Ankermgmt/ankermake-m5-muffler/README.md

# AnkerMake M5 Muffler

## Firmware

For instructions on installing firmware, see the [firmware README](firmware/README.md).

## Hardware

All files required to build the hardware are in the [hardware](hardware) directory. See the [hardware README](hardware/README.md) for more information.
