Ankermgmt/ankermake-m5-muffler/hardware/v0.7/PCB v15.pdf

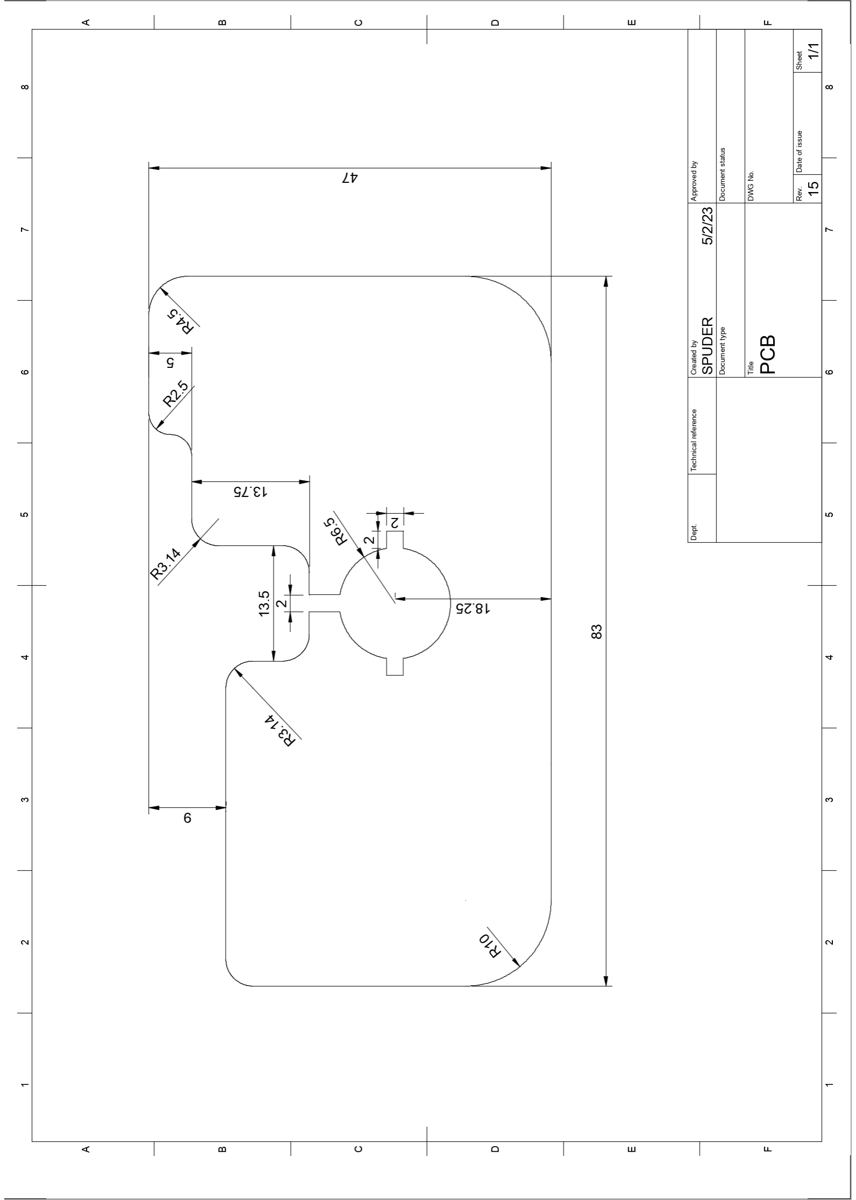
[picture p1: page 1]
