Ankermgmt/ankermake-m5-muffler/hardware/v0.6/pcb_dimensions.pdf

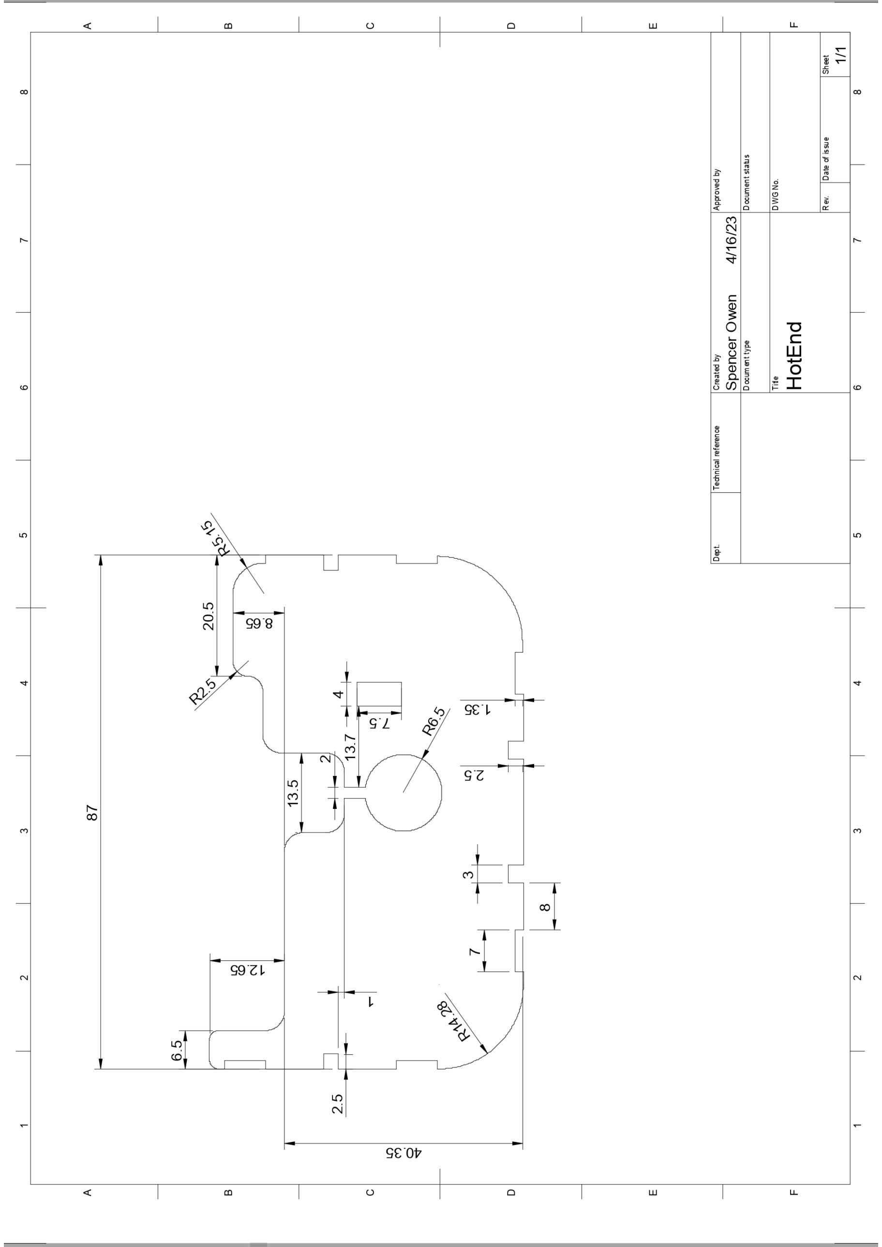
[picture p2: page 1]
