Ankermgmt/ankermake-m5-muffler/images/muffler3.png

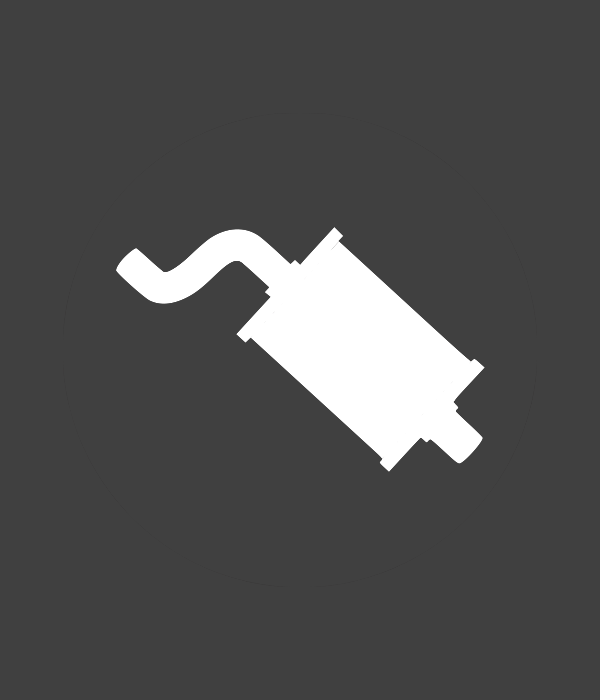
images/muffler3.png
