Ankermgmt/ankermake-m5-muffler/images/ship.png

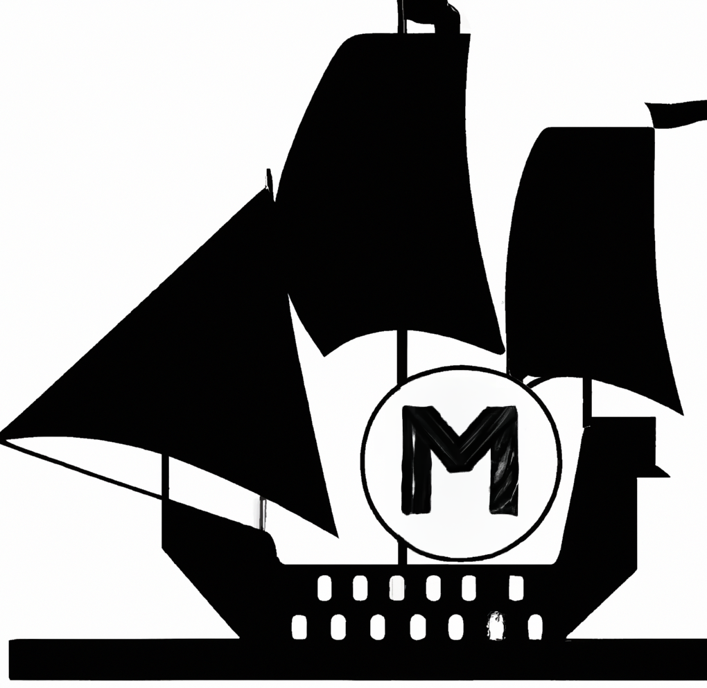
images/ship.png
