Ankermgmt/ankermake-m5-muffler/hardware/v0.7/BOM_PCB.csv

ID | Name | Designator | Footprint | Quantity | Manufacturer Part | Manufacturer | Supplier | Supplier Part | Price
1 | SK6812-SIDE-4020 | U10,U11,U12,U13,U14,U15,U16,U17,U18,U19,U20,U21,U22,U23 | SK6812-SIDE-4020 PNP | 14 | SK6812SIDE-A-RVS | 欧思科光电 | LCSC | C2890037 | 0.03
2 | 5K1 | R2,R3 | R0805 | 2 | PTFR0805B5K10N9 | RESI(开步睿思） | LCSC | C328447 | 0.026
3 | Temp | CN1 | CONN-SMD_XH-2PWBPZ | 1 | XH-2PWBPZ | BOOMELE(博穆精密) | LCSC | C2687444 | 0.012
4 | 300 | R8 | R0805 | 1 | PTFR0805B300KP9 | RESI(开步睿思） | LCSC | C2849164 | 0.023
5 | 220n | C3,C4 | C0805 | 2 | C2012X8R1E224K125AA | TDK | LCSC | C2172799 | 0.009
6 | 470u | C2 | CAP-D4.0×H5.5 | 1 |  | KNSCHA(科尼盛)
7 | BSS138W | Q1 | SOT-323-3_L2.0-W1.3-P1.30-LS2.1-BR | 1 | BSS138W-TP-ES | ElecSuper(静芯微） | LCSC | C5224284 | 0.003
8 | 10k | R5,R6 | R0805 | 2 | PTFR0805B10K0P9 | RESI(开步睿思） | LCSC | C478887 | 0.023
9 | PC817(SMD) | U4 | SMD-4_L4.6-W6.5-P2.54-LS10.2-TL-A | 1 | PC817X4CSP9F | SHARP(夏普) | LCSC | C500391 | 0.018
10 | 10u | C1 | C0805 | 1 | GRM188R71H104KA93D | muRata(村田) | LCSC | C77055 | 0.001
11 | NTR4501N | Q1-B | SOT-23-3_L2.9-W1.3-P1.90-LS2.4-BR | 1 | NTR4501NT1G | onsemi(安森美) | LCSC | C85416 | 0.034
12 | 100k | R1 | R0805 | 1 | PTFR0805B100KN9 | RESI(开步睿思） | LCSC | C328434 | 0.027
