Ankermgmt/ankermake-m5-muffler/hardware/v0.7/PCB v15.step

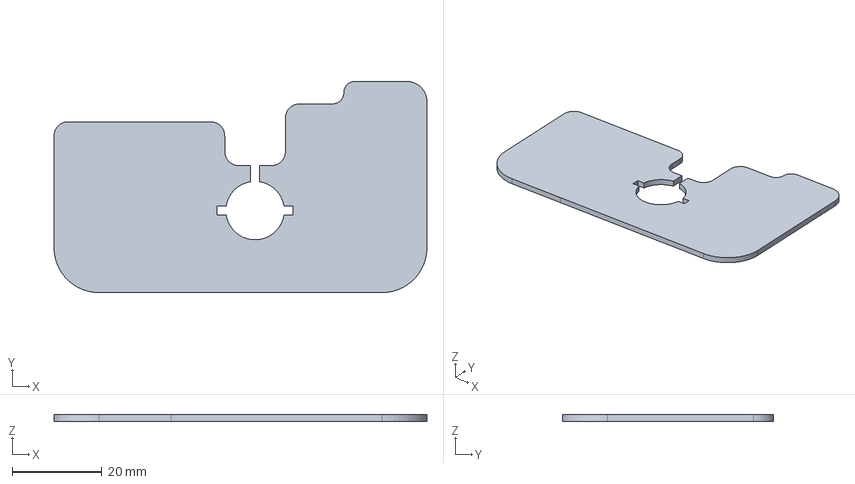
[picture p5: CAD file, 2023-04-30]
hardware/v0.7/PCB v15.step
83.0 x 47.0 x 1.50 mm
Packages
Board
1-copper
16-copper
1-soldermask
16-soldermask
