Ankermgmt/ankermake-m5-muffler/hardware/v0.7/Adapter.stl

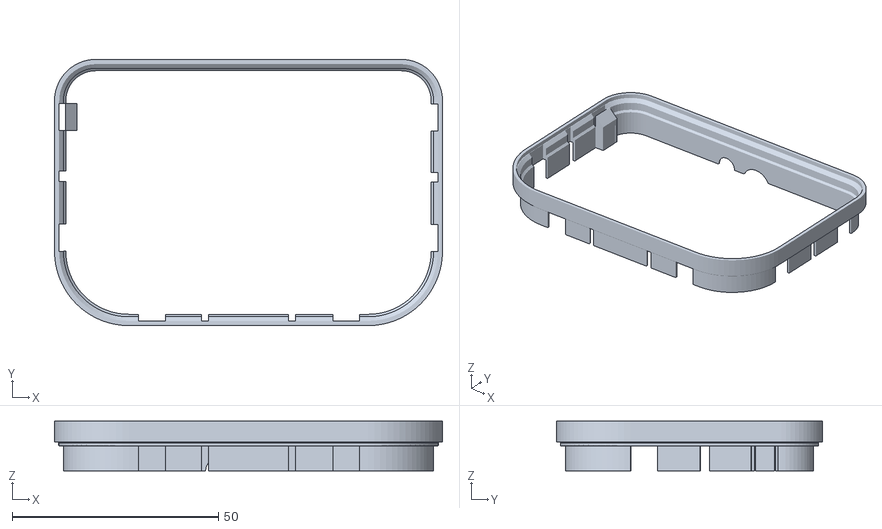
[picture p6: CAD file, 2023-04-30]
hardware/v0.7/Adapter.stl
94.0 x 64.5 x 12.0
