Ankermgmt/ankermake-m5-muffler/hardware/v0.6/PCB v9.step

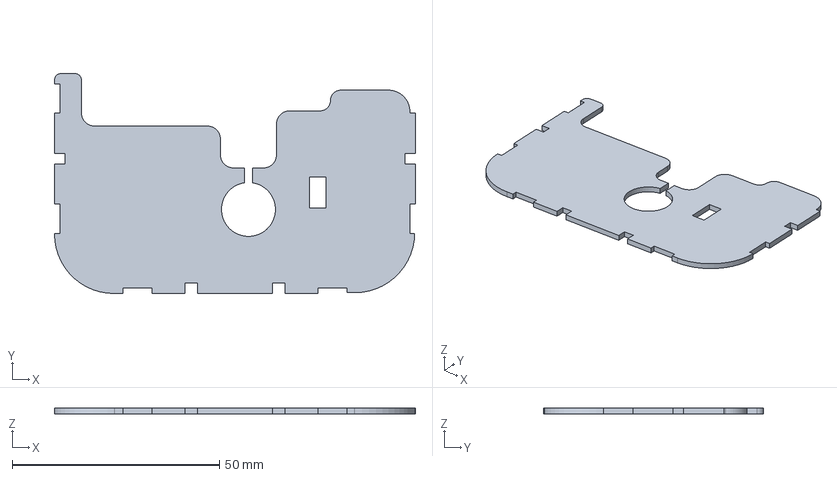
[picture p7: CAD file, 2023-04-19, an earlier design]
hardware/v0.6/PCB v9.step
87.0 x 53.0 x 1.50 mm
Packages
Board
1-copper
16-copper
1-soldermask
16-soldermask
