Ankermgmt/ankermake-m5-muffler/hardware/v0.7/PCB v12.step

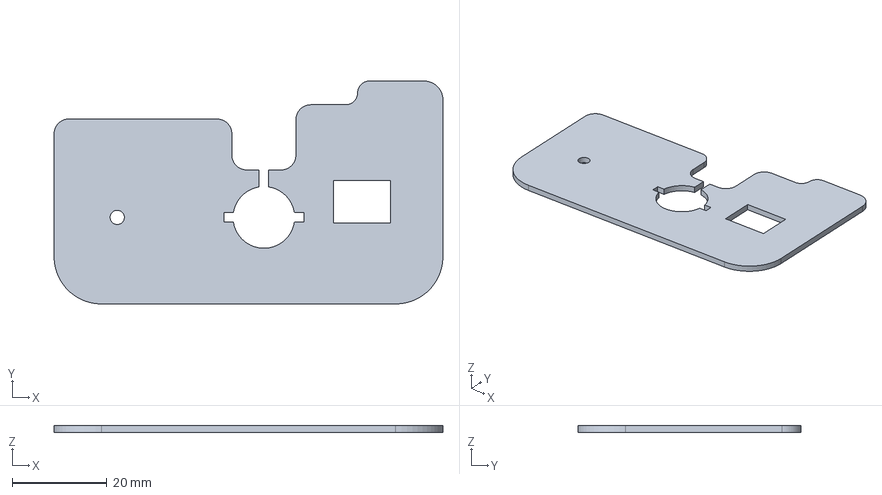
[picture p8: CAD file, 2023-04-30, an earlier design]
hardware/v0.7/PCB v12.step
82.0 x 47.0 x 1.50 mm
Packages
Board
1-copper
16-copper
1-soldermask
16-soldermask
