Ankermgmt/ankermake-m5-muffler/hardware/v0.7/PCB v11.step

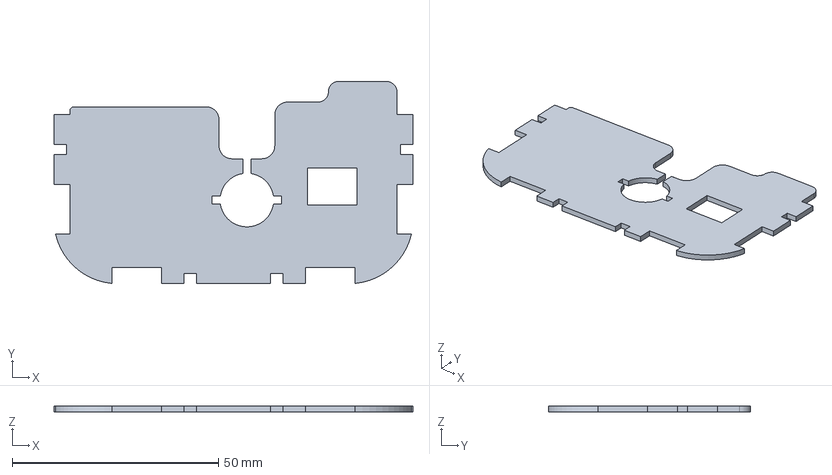
[picture p9: CAD file, 2023-04-30, an earlier design]
hardware/v0.7/PCB v11.step
87.0 x 49.0 x 1.50 mm
Packages
Board
1-copper
16-copper
1-soldermask
16-soldermask
