Ankermgmt/ankermake-m5-muffler/hardware/v0.7/PCB v14.step

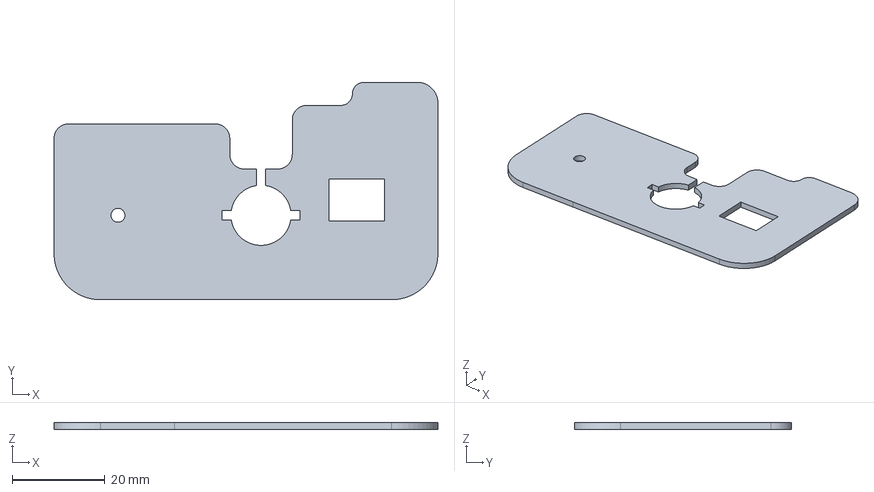
[picture p11: CAD file, 2023-04-30, an earlier design]
hardware/v0.7/PCB v14.step
83.0 x 47.0 x 1.50 mm
Packages
Board
1-copper
16-copper
1-soldermask
16-soldermask
