Ankermgmt/ankermake-m5-muffler/(list of files, cad)

Other CAD files:
hardware/v0.6/PCB v9.dxf
hardware/v0.7/PCB v10.dxf
hardware/v0.7/PCB v11.dxf
hardware/v0.7/PCB v11.stl
hardware/v0.7/PCB v12.stl
hardware/v0.7/PCB v14.dxf
hardware/v0.7/PCB v14.stl
hardware/v0.7/PCB v15.dxf
hardware/v0.7/PCB v15.stl
