Ankermgmt/ankermake-m5-muffler/hardware/v0.7/Schematic.pdf

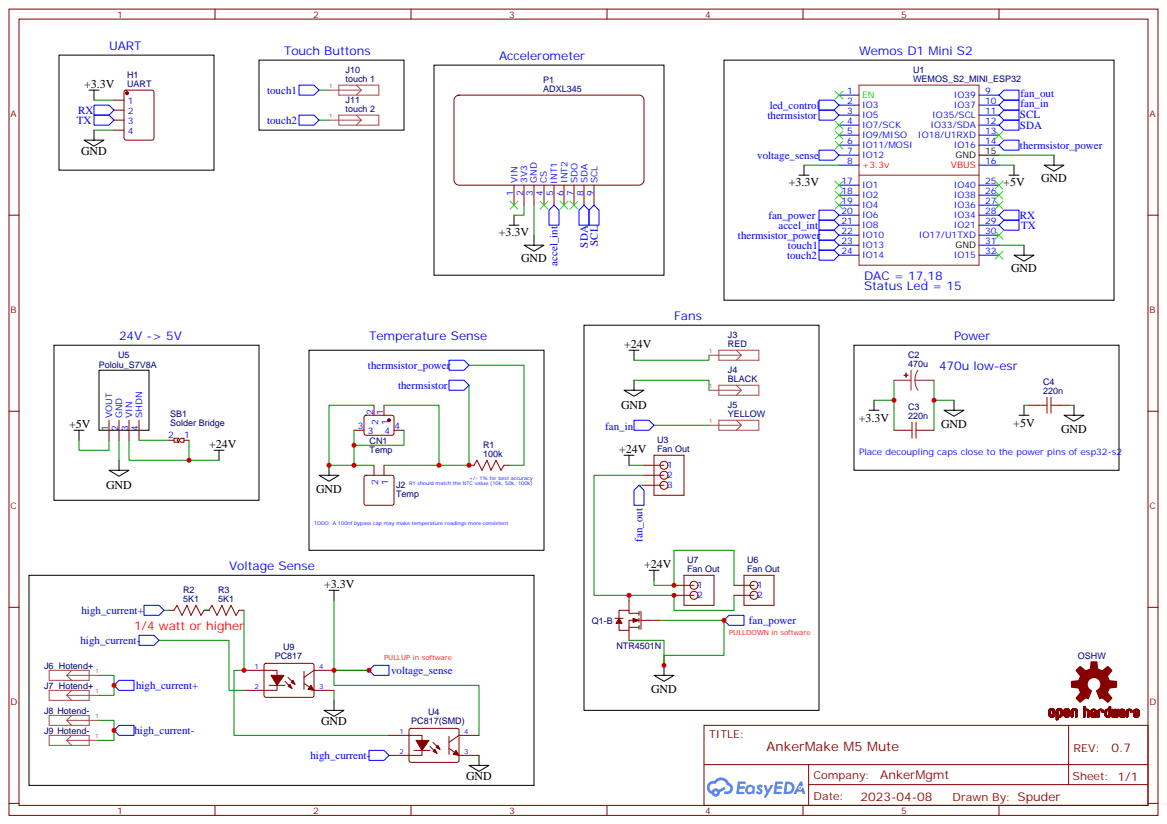
[picture p12: page 1]

Accelerometer Touch Buttons UART

Place decoupling caps close to the power pins of esp32-s2

R1 should match the NTC value (10k, 50k, 100k)
Temp

TODO: A 100nf bypass cap may make temperature readings more consistent

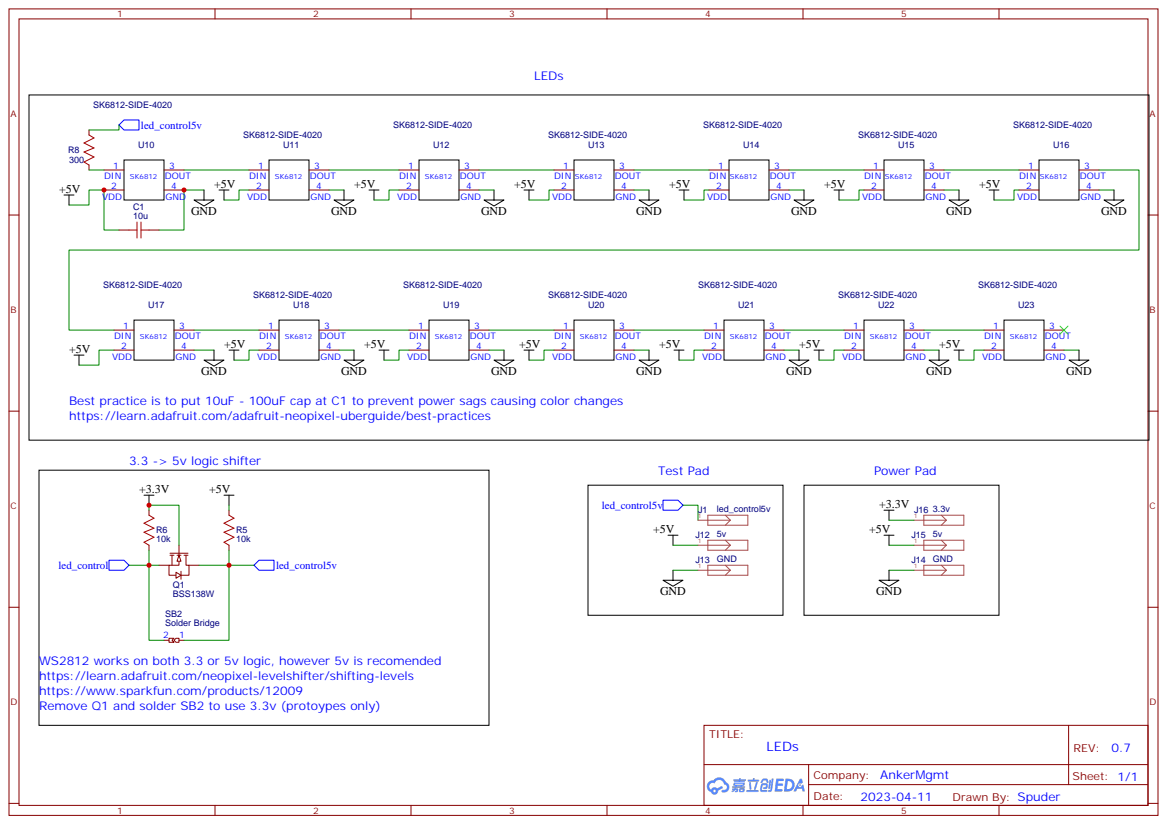
[picture p13: page 2]

Best practice is to put 10uF - 100uF cap at C1 to prevent power sags causing color changes
https://learn.adafruit.com/adafruit-neopixel-uberguide/best-practices

WS2812 works on both 3.3 or 5v logic, however 5v is recomended
https://learn.adafruit.com/neopixel-levelshifter/shifting-levels
https://www.sparkfun.com/products/12009
Remove Q1 and solder SB2 to use 3.3v (protoypes only)

A | A
B | B
C | C
D | D

TITLE:
Sheet_1 | REV: 1.0
| Drawn By: Spencer Owen

Company: Your Company
