Ankermgmt/ankermake-m5-muffler/hardware/v0.7/Bottom.pdf

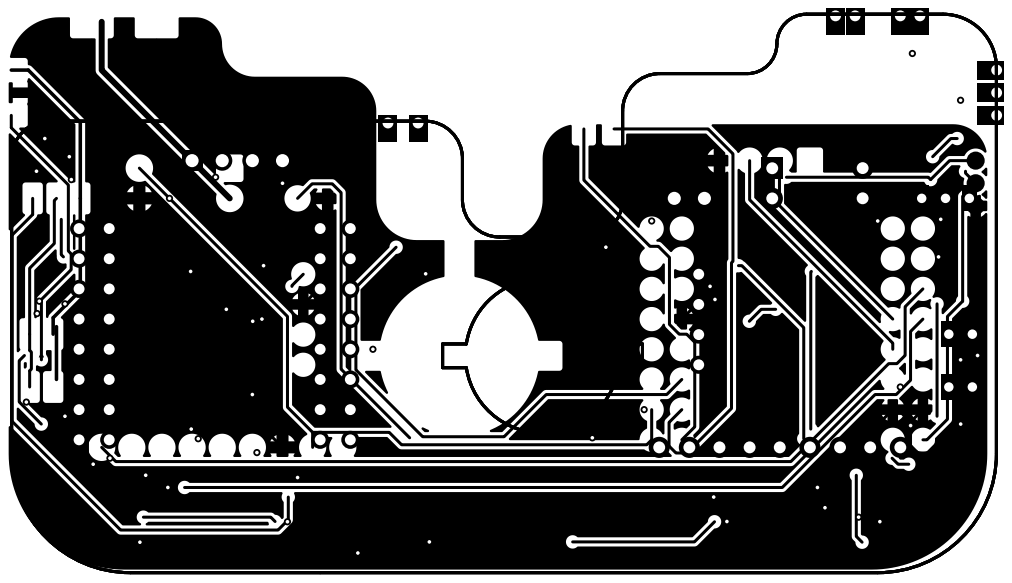
[picture p14: page 1]
