Ankermgmt/ankermake-m5-muffler/hardware/v0.7/Top.pdf

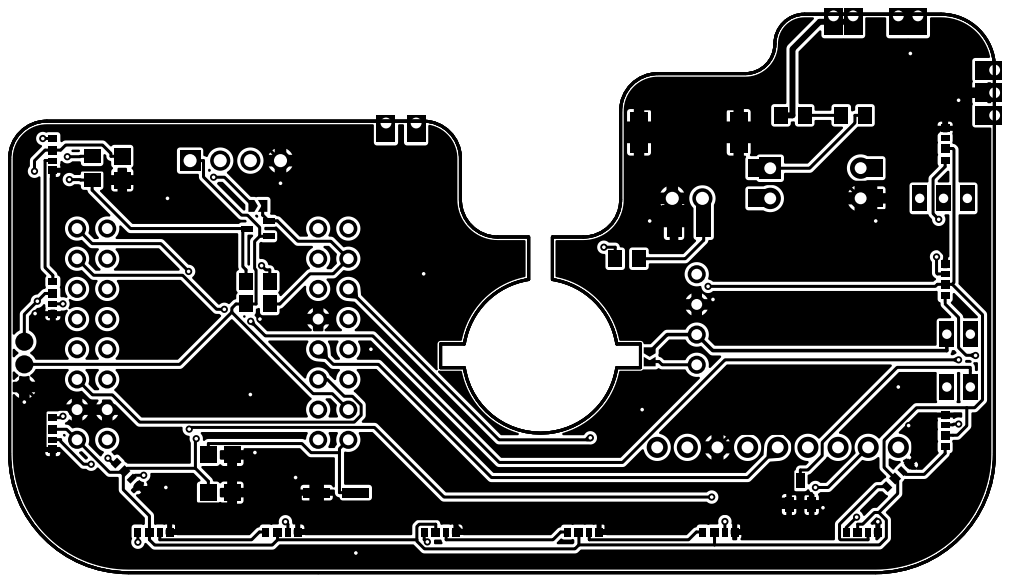
[picture p15: page 1]
