Ankermgmt/ankermake-m5-muffler/hardware/v0.6/pcb_schematic.pdf

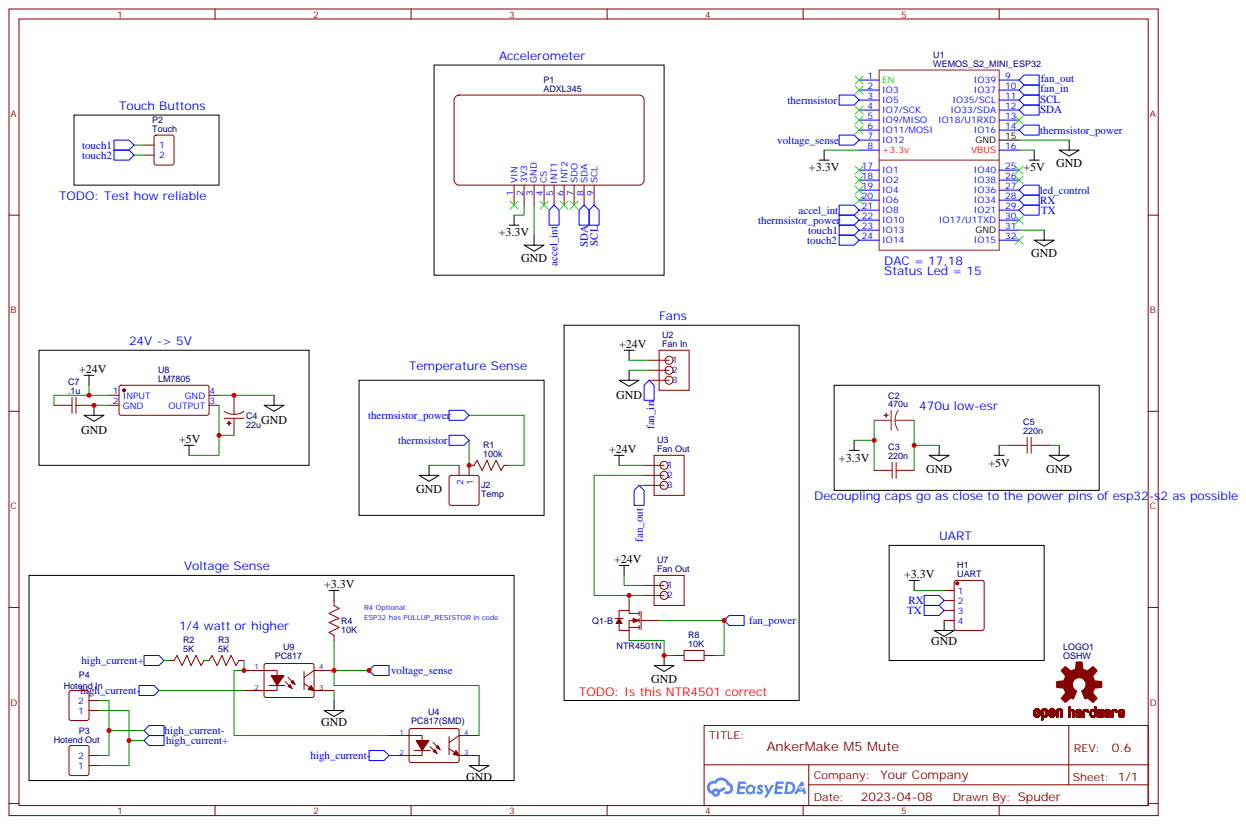
[picture p16: page 1]

TODO: Test how reliable

Decoupling caps go as close to the power pins of esp32-s2 as possible

TODO: Is this NTR4501 correct

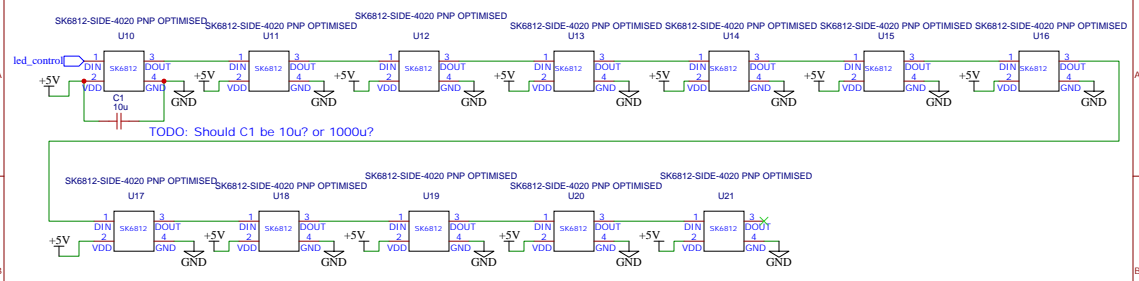
[picture p17: page 2]
