Ankermgmt/ankermake-m5-muffler/hardware/v0.6/pcb_bottom.pdf

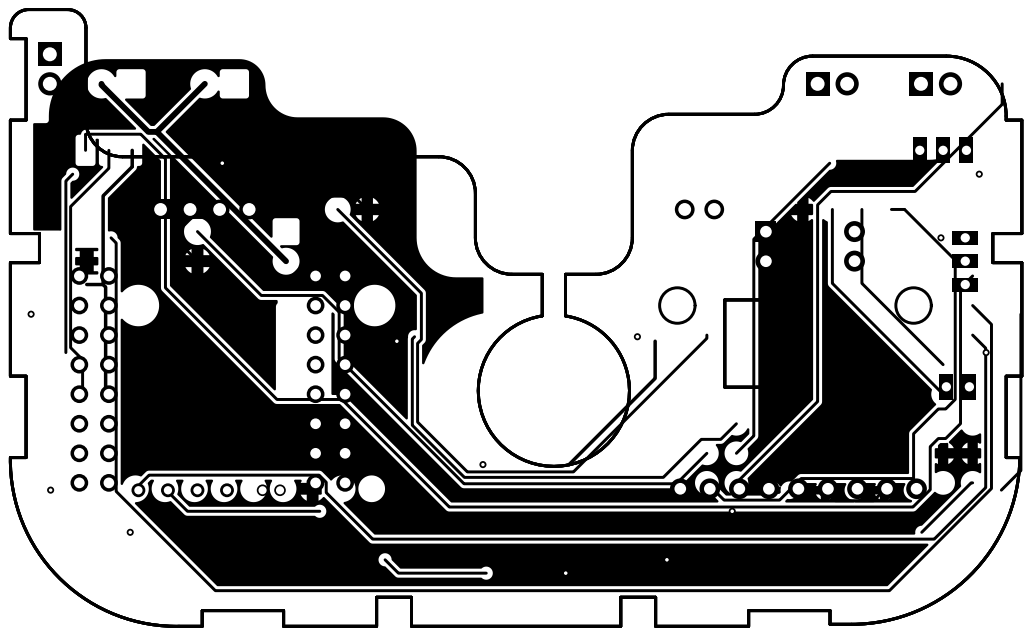
[picture p18: page 1]
