Ankermgmt/ankermake-m5-muffler/hardware/v0.6/pcb_top.pdf

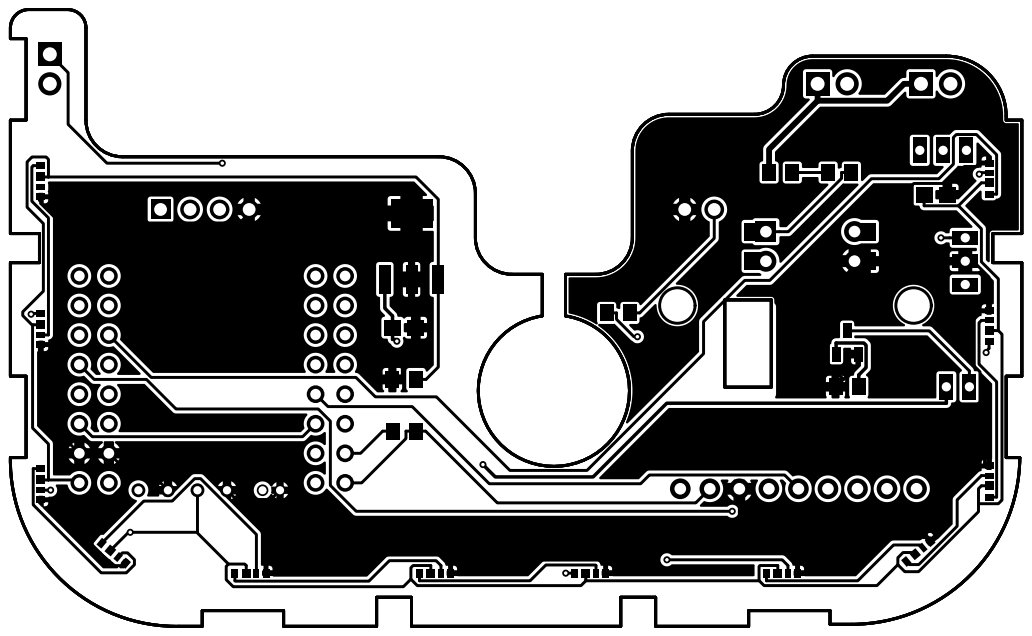
[picture p19: page 1]
