Ankermgmt/ankermake-m5-muffler/(list of files, drawings)

Other design files:
hardware/v0.7/Autorouter.dsn
hardware/v0.7/EasyEDA-PCB.json
hardware/v0.7/EasyEDA-SCH.json
