Ankermgmt/ankermake-m5-muffler/(threads)

Thread 1 (2023-04-28):

ADXL345

thomasjpatterson, 2023-04-28:

thomasjpatterson, 2023-05-14:
Internal Poll Results as of 14-05-2023:
1) When would you attach the accelerometer?:
- 4 votes permanently,
- 2 votes occasional use

2) Would you use the accelerometer if it did not fit inside the case?
- 1 vote Yes, I don't care how it looks
- 5 votes to make it pretty.

Thread 11 (2023-04-28):

Integration Testing

thomasjpatterson, 2023-04-28:

thomasjpatterson, 2023-05-14:
Full integration test failure today. Despite the heater being on, the muffler still thought the voltage was 0v and so it didn’t register that the heater was running.

Watching the voltage on a multimeter the heater turns on for a few seconds then off for a few seconds. That exposes a problem where the fan theoretically could flop on and off while the printer is heating until it reaches the 30 deg threshold.

Solution is going to be to add a simple PID loop or window where if the heater has been on in the last X seconds then assume it is still on

thomasjpatterson, 2023-05-14:
Whew, finally found the problem. Turns out that I made a mistake all the way back in version 0.6 schematic but I never caught it.
voltage_sense is using built in pull_up resistor on the micro controller so it would never go low.

Prototypes will need jumper wires, and this will be fixed in v0.8

Thread 15 (2023-04-28):

ESP32-S2-Solo-2-N4

thomasjpatterson, 2023-04-28:
Switching to the ESP32-S2-Solo-2-N4 would be enough GPIO for all 3 features.

It would complicate the power since there is no simple clean power that the D1 mini provides

Would also need to figure out how to add USB-C to the board

Thread 3 (2023-04-28):

LED Control

thomasjpatterson, 2023-04-28:

thomasjpatterson, 2023-05-10:
Previous prototypes were using 3.3v logic against 5v LEDs which can lead to inconsistent colors and cause the LEDs to act weird. The previous prototype had no issues with the voltage mis match, but so far the v0.7 boards aren't liking the lower voltage.

Good news is that I planned ahead for this and have a solder bridge that just needs to be left disconnected and a logic level shifting mosfet to be put in its place. When those mosfets arrive today I'll verify that the LEDs are more stable.

thomasjpatterson, 2023-05-10:
The last hurdle to getting a couple of these shipped out is figuring out how to make soldering the LEDs easier. Even with hotair and an extremely fine soldering tip, I'm still destroying about 10% of the LEDs and also pulling out about 10% of my hair trying to get them to flow well. The release version will be pick and place so it won't be an issue

Thread 5 (2023-04-28):

Touch Sensor Support

thomasjpatterson, 2023-04-28:
The touch sensors do not work in ESPHome because of this issue:

https://github.com/esphome/issues/issues/4411

## Solution

1. Wait for touch support to be added
2. Open Pull request adding support

Thread 8 (2023-04-28):

Secondary Suppliers for NTC

thomasjpatterson, 2023-04-28:

thomasjpatterson, 2023-05-02:
100k
13cm
JST-XH
Tag (ring) style connector

$0.29 each

https://a.aliexpress.com/_m0bRuu4
