Ankermgmt/ankermake-m5-muffler/firmware/config.yaml

substitutions:
  name: ankermake-m5-muffler
  friendly_name: AnkerMake M5 Muffler
  ntc_resistance: 100kOhm # 10kOhm, 50kOhm, 100kOhm are common values. R1 resistor must match this value
  log_level: INFO # DEBUG, INFO, WARNING, ERROR, NONE
  rgb_order: GRB # RGB, GRB, BGR, BRG, GBR, RGBW, GRBW

esphome:
  name: ${name}
  friendly_name: ${friendly_name}
  platformio_options:
    board_build.extra_flags:
      - "-DARDUINO_USB_CDC_ON_BOOT=0" # https://github.com/esphome/issues/issues/3988#issuecomment-1399025200
  on_boot:
    then:
      - logger.log: "AnkerMake M5 Muffler Booting..."
      - delay: 5s
      - state_machine.set: NORMAL #TODO: would a READY state be better?
  on_loop:
    then:
      # TODO: validate fan duty cycle is within range
      lambda: |-
        float ntc_temp = id(ntc_sensor).state;
        bool heater_on = id(heater).state;
        bool is_error = false;
        bool is_safe_for_silence = false;

        if (ntc_temp < 5 || ntc_temp > 260) {
          is_error = true;
        }

        if (ntc_temp > 5 && ntc_temp < 30) {
          is_safe_for_silence = true;
        }

        if (heater_on) {
          is_safe_for_silence = false;
        }

        if (is_error) {
          if (id(state_machine_mode).current_state() != "ERROR") {
            id(state_machine_mode).transition("ERROR_ENTER");
          }
        } else {
          if (id(state_machine_mode).current_state() != "BOOTING") {
            if (id(state_machine_mode).current_state() == "ERROR") {
              if (id(previous_state) == "NORMAL") {
                id(state_machine_mode).transition("ERROR2NORMAL");
              } else if (id(previous_state) == "SILENCED") {
                id(state_machine_mode).transition("ERROR2SILENCED");
              }
            }

            if (is_safe_for_silence) {
              // If we are not in user override mode, then switch to silenced mode automatically
              id(state_machine_mode).set("SILENCED");
            } else {
              id(state_machine_mode).set("NORMAL");
            }
          }
        }

# There are 2 frameworks, arduino and esp-idf
# esp-idf is recomended on the esp32s2 however it does not work with neopixel or fastled libraries
# There is fastled-idf however integrating it with esphome is an unblazed trail
# Leaving on the arduino framework for now
# The advantage of esp-idf is it may have better support for CDC boot mode allowing
# for improv_serial to work (currently does not work in arduino framework)
# https://community.home-assistant.io/t/enable-usb-cdc-to-log-hello-world-to-esp32-s3-dev-board-for-esphome/463164/12
# https://github.com/esphome/esphome/pull/4225/files
esp32:
  board: lolin_s2_mini
  variant: esp32s2
  framework:
    type: arduino
    version: 2.0.7 # https://github.com/espressif/arduino-esp32/releases
    platform_version: 6.1.0 # https://github.com/platformio/platform-espressif32/releases/
  # framework:
  #   type: esp-idf
  #   version: 4.3.2
  #   sdkconfig_options:
  #     CONFIG_ESP_CONSOLE_USB_CDC: y

logger:
  hardware_uart: UART0
  # hardware_uart: USB_CDC
api:
  reboot_timeout: 0s
ota:

dashboard_import:
  package_import_url: github://Ankermgmt/ankermake-m5-muffler/ESPHome/config.yaml@main
  import_full_config: false # or true

# esp32s2 does not yet support USB CDC, which means a serial port
# only appears when in DFU mode (not when plugged into a computer normally)
# Until USB CDC is supported on the esp32s2, improv_serial will not work
# improv_serial:
  # next_url: https://example.com/project-template/manual?ip={{ip_address}}&name={{device_name}}&version={{esphome_version}}

packages:
  accelerometer: !include conf.d/accelerometer.yaml
  ambient_temperature: !include conf.d/ambient_temperature.yaml
  button: !include conf.d/button.yaml
  fan_input: !include conf.d/fan_input.yaml
  fan_output: !include conf.d/fan_output.yaml
  # leds-neopixel: !include conf.d/leds-neopixel.yaml
  leds-fastled: !include conf.d/leds-fastled.yaml
  state_machine: !include conf.d/state_machine.yaml
  status_led: !include conf.d/status_led.yaml
  temperature_sensor: !include conf.d/temperature_sensor.yaml
  uart: !include conf.d/uart.yaml
  uptime: !include conf.d/uptime.yaml
  voltage_sensor: !include conf.d/voltage_sensor.yaml
  wifi: !include conf.d/wifi.yaml
  web_server: !include conf.d/web_server.yaml

  # Uncomment this for development
  # Note: Peforming subsequent uploads using the OTA will preserve the wifi settings
  # Making having to enter the wifi credentials every time unnecessary
  debug: !include conf.d/debug.yaml
