Ankermgmt/ankermake-m5-muffler/(commit log)

2023-04-16 add esphome config
    [state_machine.yaml]
2023-04-16 Rename to firmware
    [state_machine.yaml]
2023-04-16 Add hardware readme
    [BOM.csv, PCB v9.dxf, PCB v9.step]
2023-04-18 Updated temp sensors
    [state_machine.yaml]
2023-04-18 Working temperature sensor
2023-04-18 Cleanup Temperature Code
2023-04-19 Fix state machine Prevent sleep Parameterize RGB order
    [state_machine.yaml]
2023-04-19 Add Party Mode
    [state_machine.yaml]
2023-04-19 Add booting sequence
    [state_machine.yaml]
2023-04-19 Improve boot sequence
    [state_machine.yaml]
2023-04-19 Add temperature safeguard
    [state_machine.yaml]
2023-04-20 working error handler
    [state_machine.yaml]
2023-04-21 Add fan logic to error handler Add UART
    [state_machine.yaml]
2023-04-21 Fix boot mode skipped
    [config.yaml]
2023-04-21 Add hotend fan mostfet status Remove debug that was causing issues
2023-04-21 Add heater sensing Add 50% fan to normal
    [state_machine.yaml]
2023-04-26 improve leds, invert fan
    [leds-fastled.yaml]
2023-04-27 working PWM
2023-04-28 Working fan input duty cycle
    [state_machine.yaml]
2023-04-30 Correct pullup/down resistors
2023-04-30 Add v0.7 hardware
    [Adapter.stl, Autorouter.dsn, BOM_PCB.csv, EasyEDA-PCB.json, EasyEDA-SCH.json, PCB v10.dxf, PCB v10.step, PCB v11.dxf]
2023-05-02 Add PCB dimensions
